sainikhil849/momo-esp32c3-desk-companion/4_Pictures/46_expressions.png

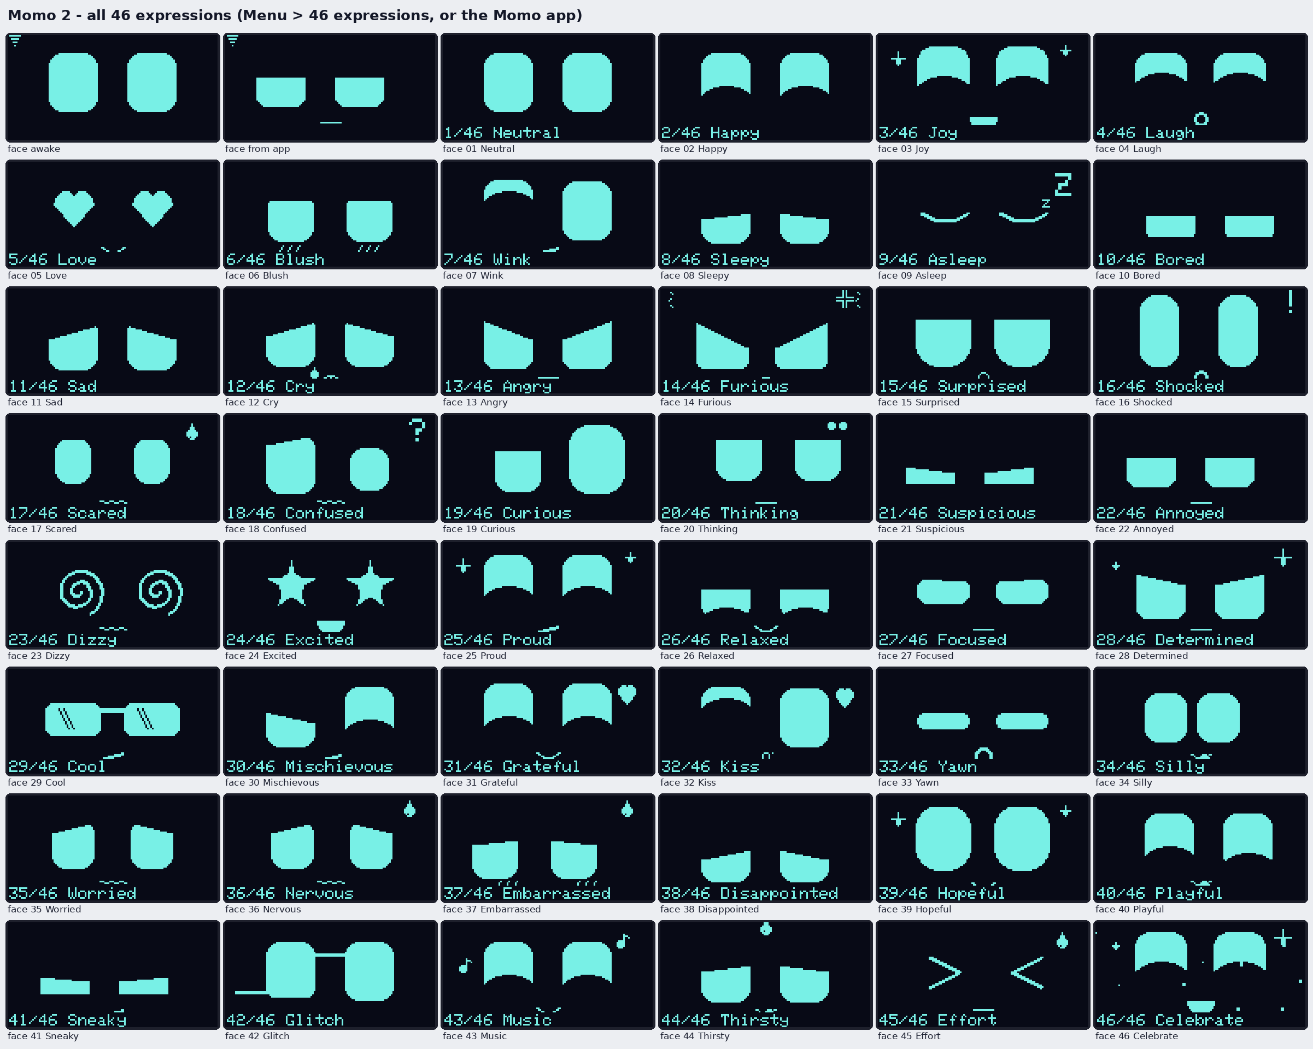
4_Pictures/46_expressions.png
