sainikhil849/momo-esp32c3-desk-companion/4_Pictures/app_01_pair.png

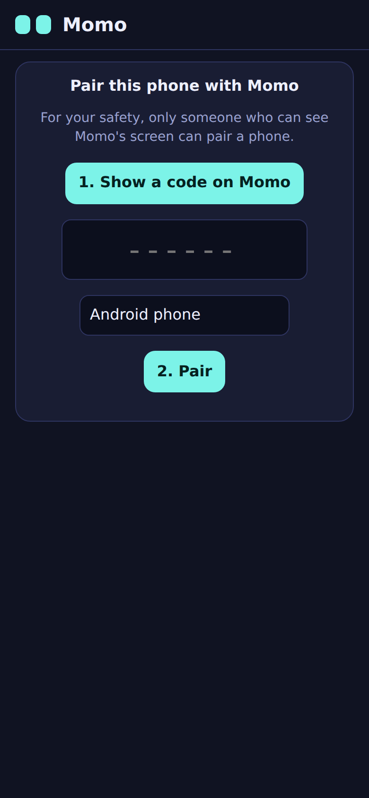
4_Pictures/app_01_pair.png
