sainikhil849/momo-esp32c3-desk-companion/4_Pictures/app_06_more.png

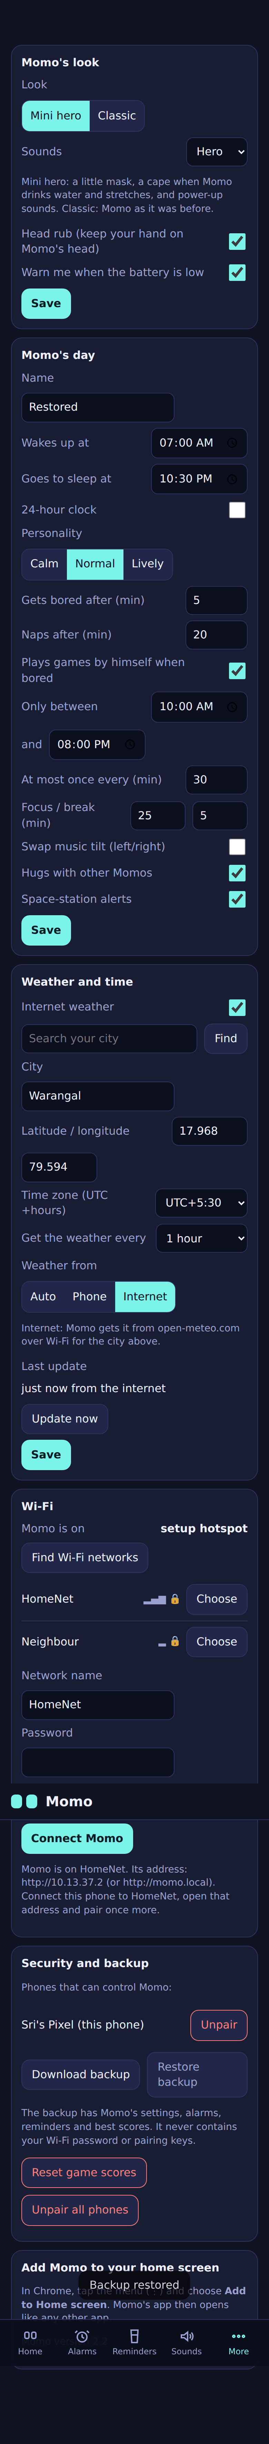
4_Pictures/app_06_more.png
