sainikhil849/momo-esp32c3-desk-companion/4_Pictures/enclosures_three.png

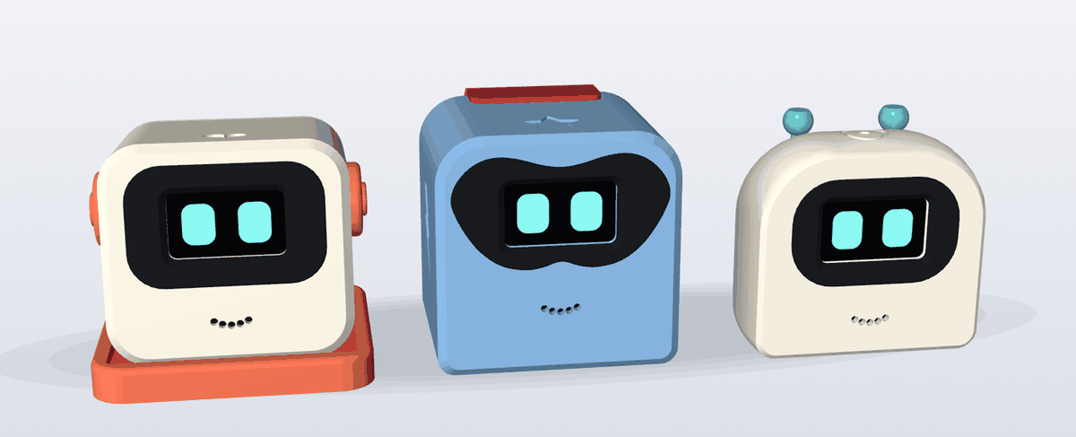
4_Pictures/enclosures_three.png
