sainikhil849/momo-esp32c3-desk-companion/4_Pictures/my_reminders.png

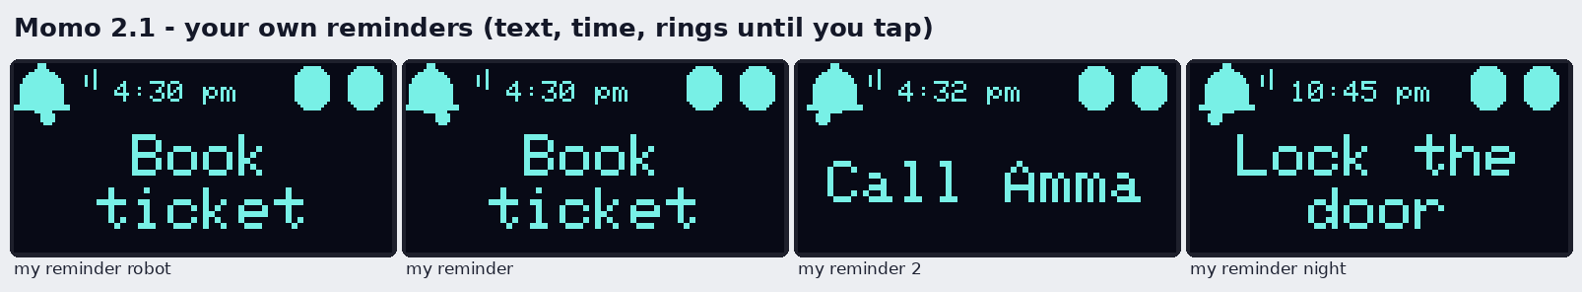
4_Pictures/my_reminders.png
