sainikhil849/momo-esp32c3-desk-companion/4_Pictures/new_games.png

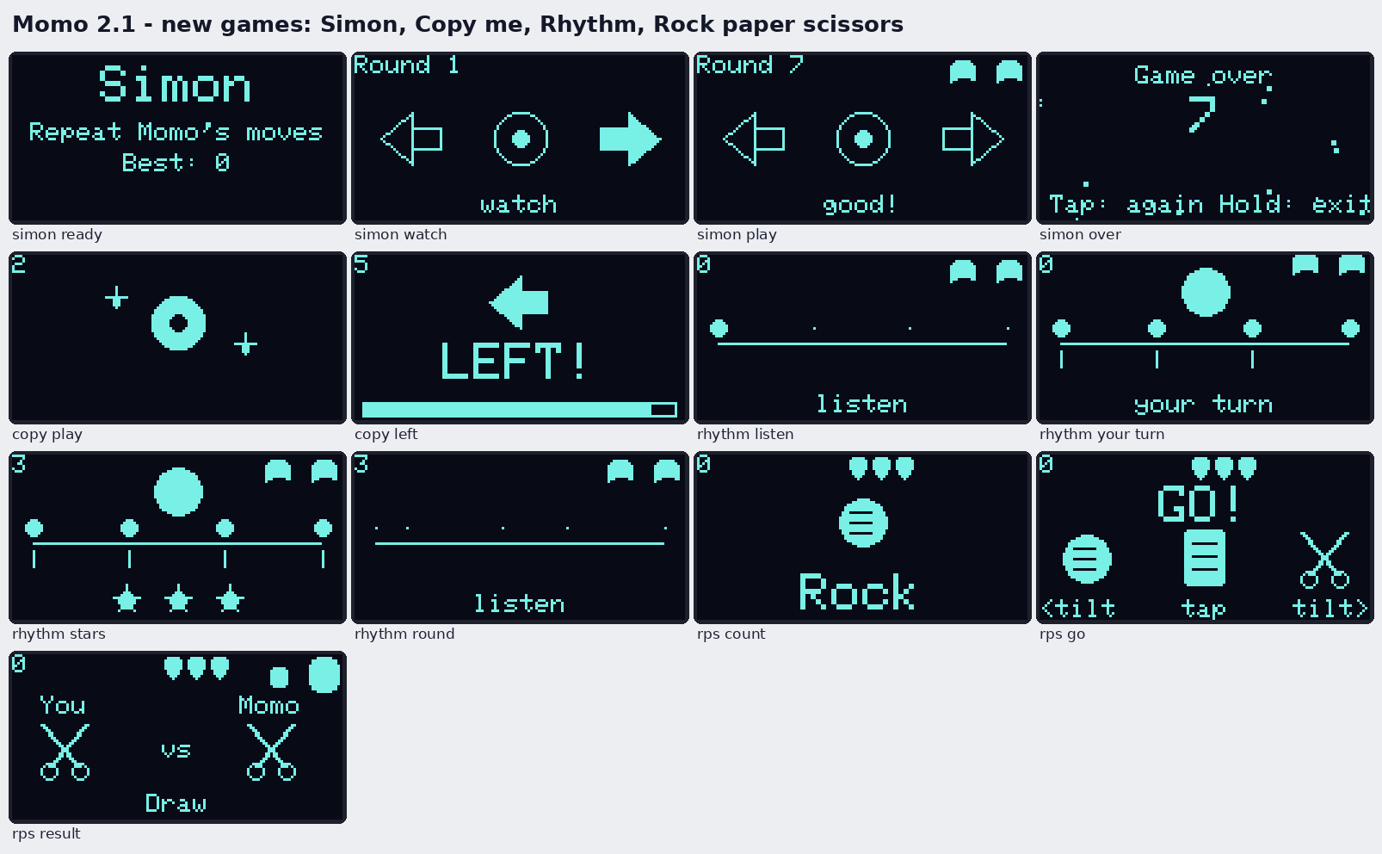
4_Pictures/new_games.png
