sainikhil849/momo-esp32c3-desk-companion/4_Pictures/screens_robot_phone.png

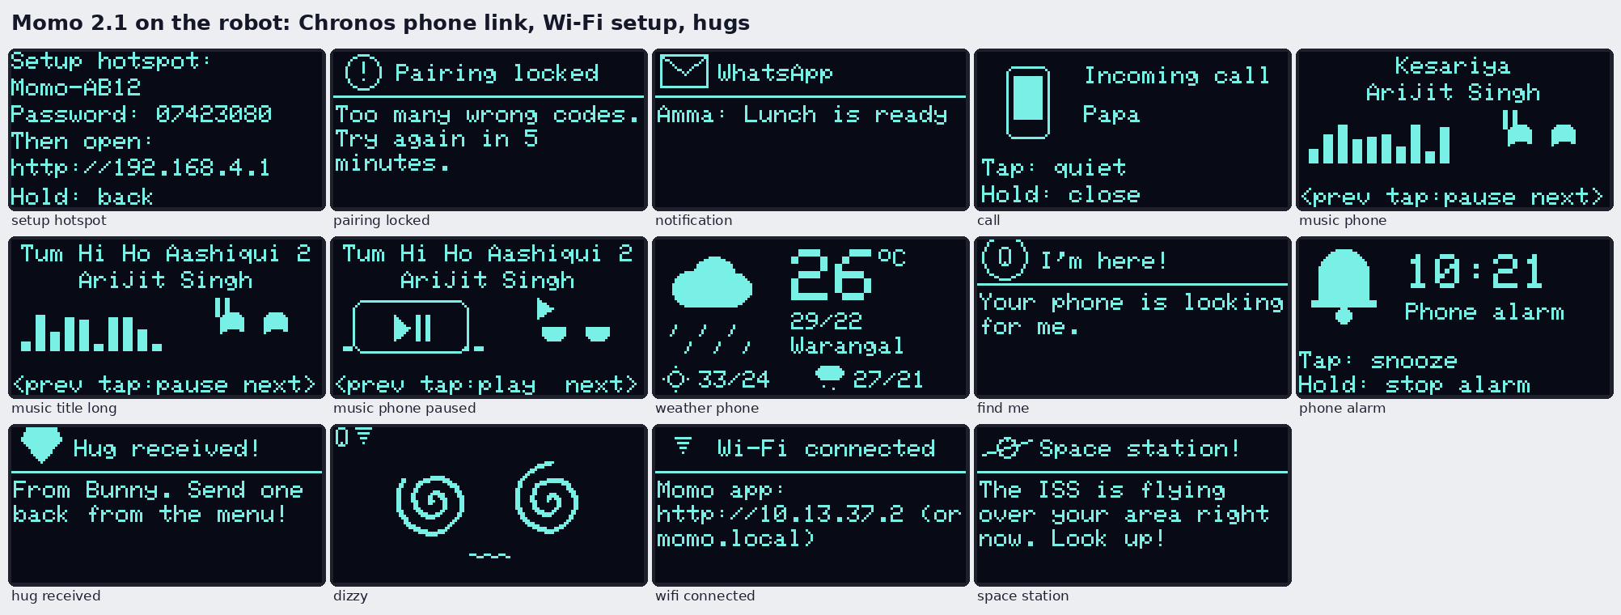
4_Pictures/screens_robot_phone.png
