sainikhil849/momo-esp32c3-desk-companion/4_Pictures/screens_simulator.png

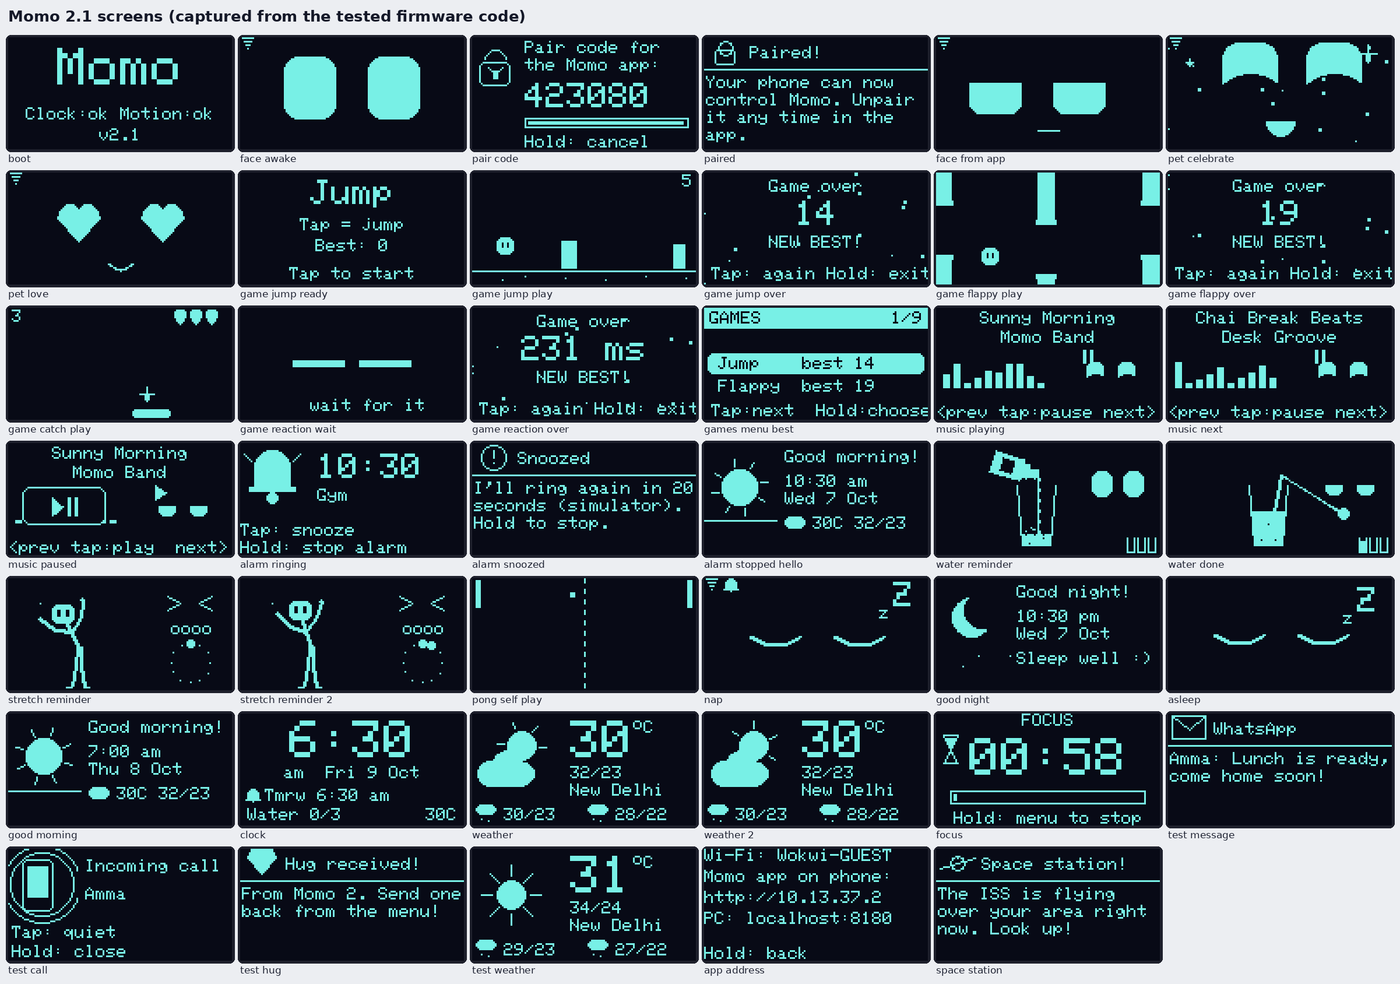
4_Pictures/screens_simulator.png
