sainikhil849/momo-esp32c3-desk-companion/4_Pictures/water_and_stretch_animations.png

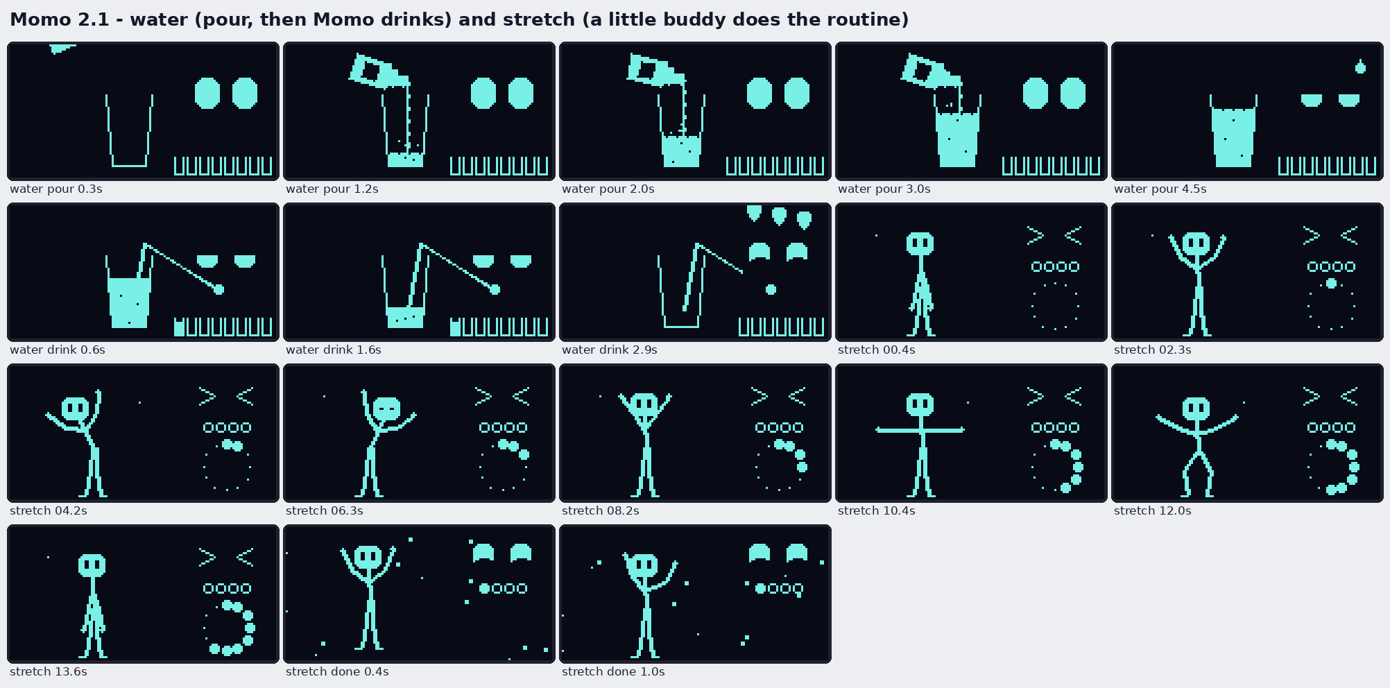
4_Pictures/water_and_stretch_animations.png
