sainikhil849/momo-esp32c3-desk-companion/5_Enclosures/pictures/A_cube_top.png

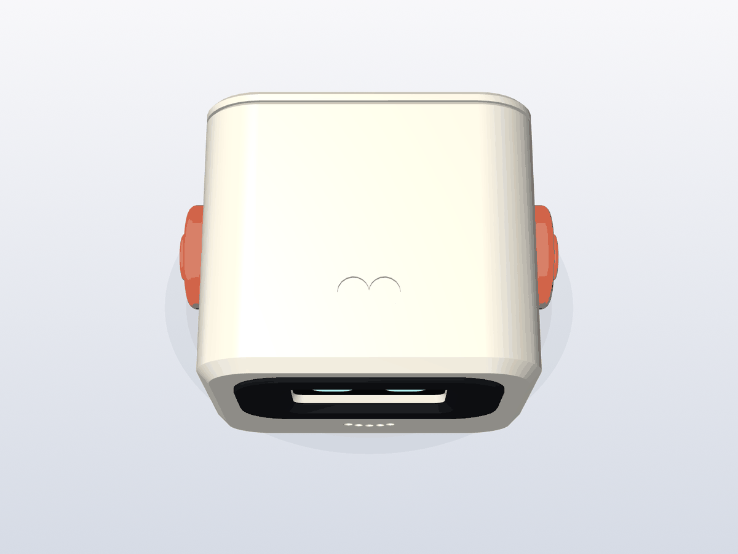
5_Enclosures/pictures/A_cube_top.png
