sainikhil849/momo-esp32c3-desk-companion/5_Enclosures/A_Momo_Cube/A_Cube_plate2_coral.3mf

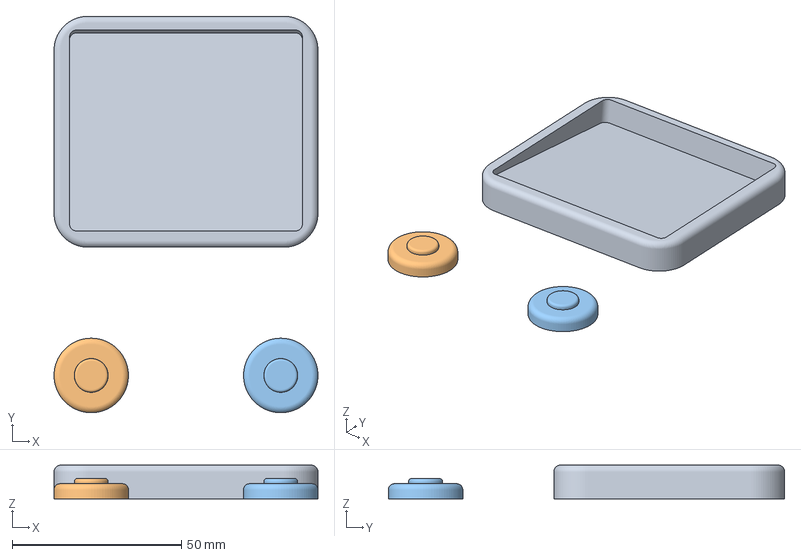
[picture p56: CAD file, 2026-10-12]
5_Enclosures/A_Momo_Cube/A_Cube_plate2_coral.3mf
78.0 x 117.1 x 10.0 mm
A_cube_dock_1
A_cube_ear_2
A_cube_ear_3
