sainikhil849/momo-esp32c3-desk-companion/5_Enclosures/A_Momo_Cube/STEP/A_cube_ear.step

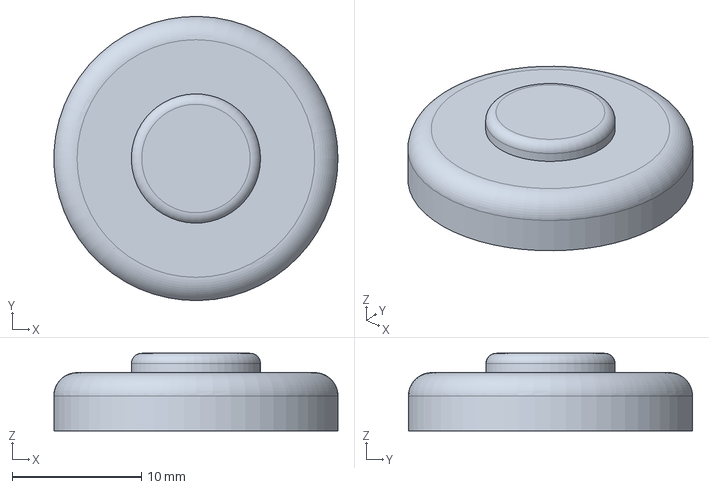
[picture p57: CAD file, 2026-10-12]
5_Enclosures/A_Momo_Cube/STEP/A_cube_ear.step
22.0 x 22.0 x 6.00 mm
