sainikhil849/momo-esp32c3-desk-companion/5_Enclosures/B_Momo_Pod/B_Pod_plate2_mint.3mf

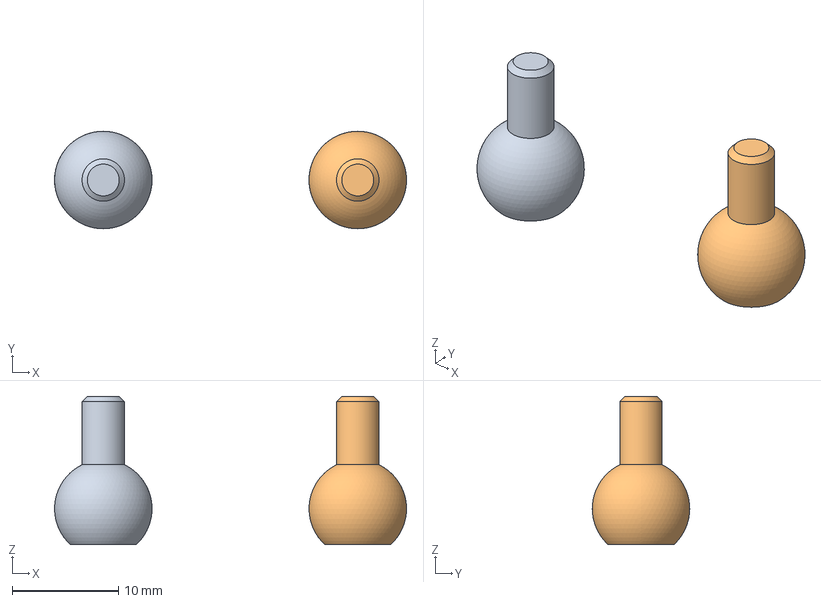
[picture p58: CAD file, 2026-10-12]
5_Enclosures/B_Momo_Pod/B_Pod_plate2_mint.3mf
33.2 x 9.20 x 14.0 mm
B_pod_antenna_1
B_pod_antenna_2
