sainikhil849/momo-esp32c3-desk-companion/5_Enclosures/B_Momo_Pod/STEP/B_pod_antenna.step

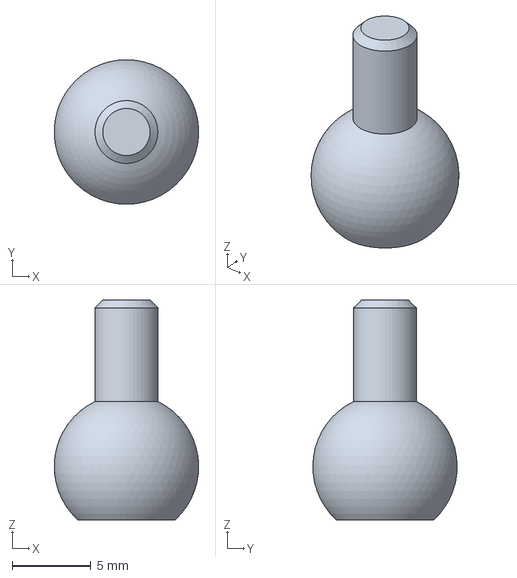
[picture p59: CAD file, 2026-10-12]
5_Enclosures/B_Momo_Pod/STEP/B_pod_antenna.step
9.19 x 9.20 x 14.0 mm
