sainikhil849/momo-esp32c3-desk-companion/5_Enclosures/C_Hero_Momo/C_Hero_plate2_red.3mf

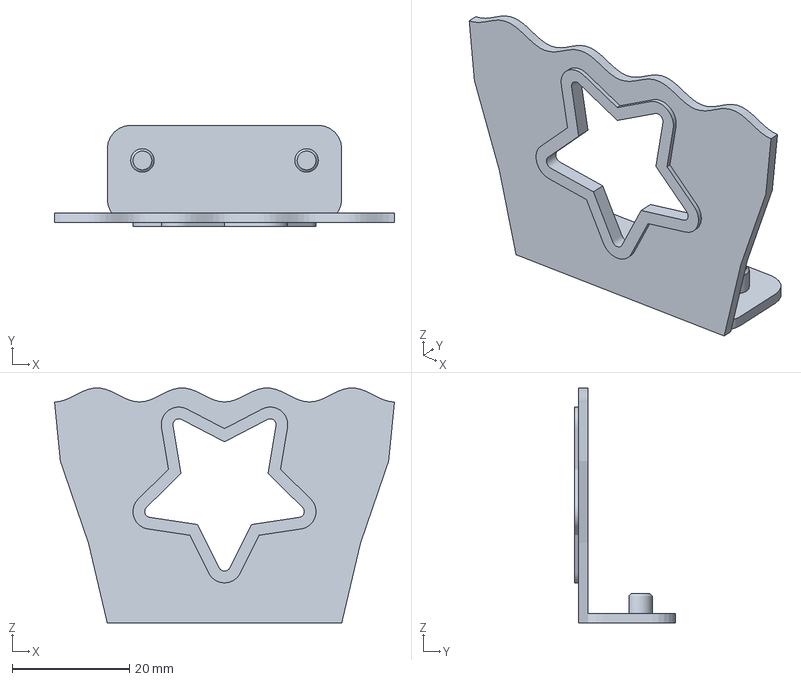
[picture p60: CAD file, 2026-10-12]
5_Enclosures/C_Hero_Momo/C_Hero_plate2_red.3mf
58.0 x 17.3 x 40.1 mm
