sainikhil849/momo-esp32c3-desk-companion/5_Enclosures/C_Hero_Momo/STEP/C_hero_mask.step

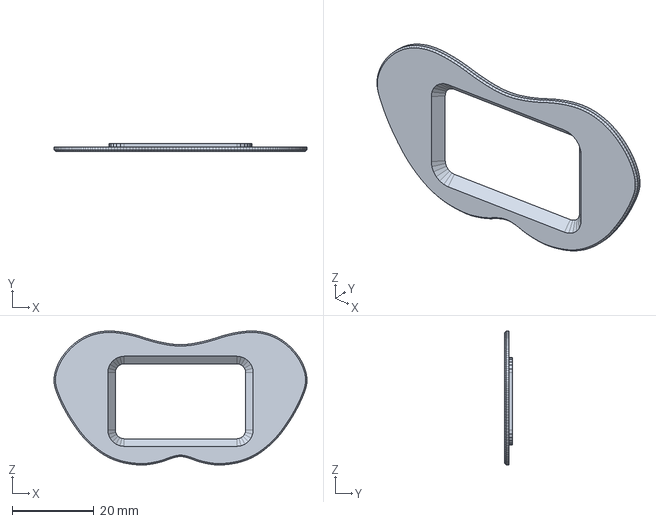
[picture p61: CAD file, 2026-10-12]
5_Enclosures/C_Hero_Momo/STEP/C_hero_mask.step
61.8 x 1.85 x 32.7 mm
