sainikhil849/momo-esp32c3-desk-companion/5_Enclosures/A_Momo_Cube/A_Cube_plate3_black.3mf

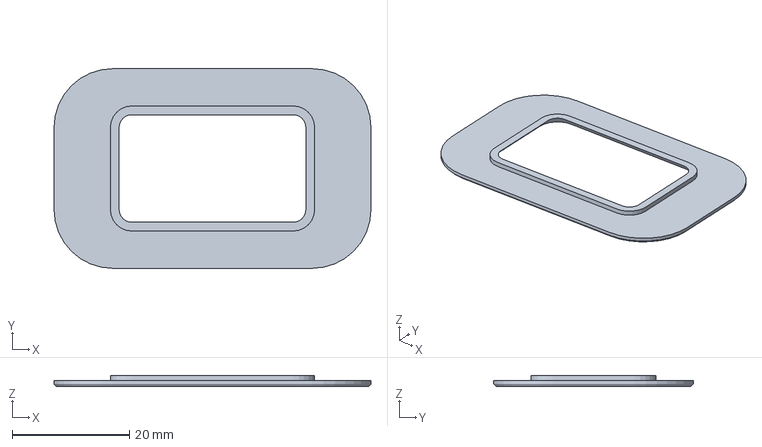
[picture p62: CAD file, 2026-10-12]
5_Enclosures/A_Momo_Cube/A_Cube_plate3_black.3mf
54.0 x 34.0 x 1.85 mm
