sainikhil849/momo-esp32c3-desk-companion/5_Enclosures/B_Momo_Pod/B_Pod_plate3_black.3mf

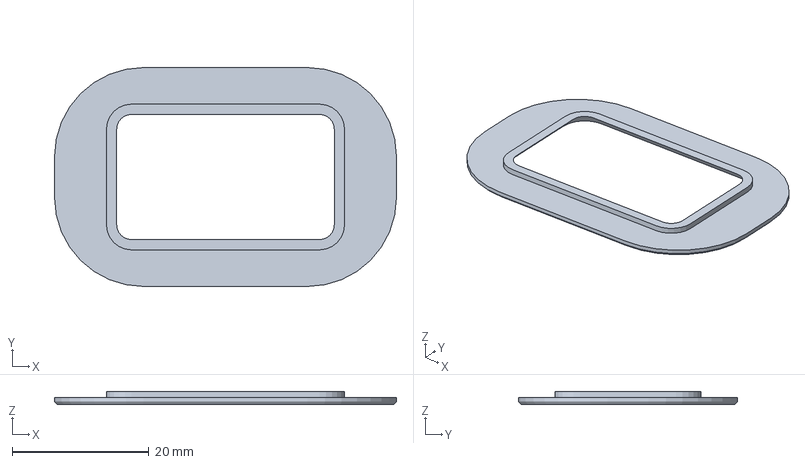
[picture p63: CAD file, 2026-10-12]
5_Enclosures/B_Momo_Pod/B_Pod_plate3_black.3mf
50.0 x 32.0 x 1.85 mm
