sainikhil849/momo-esp32c3-desk-companion/5_Enclosures/B_Momo_Pod/STEP/B_pod_back.step

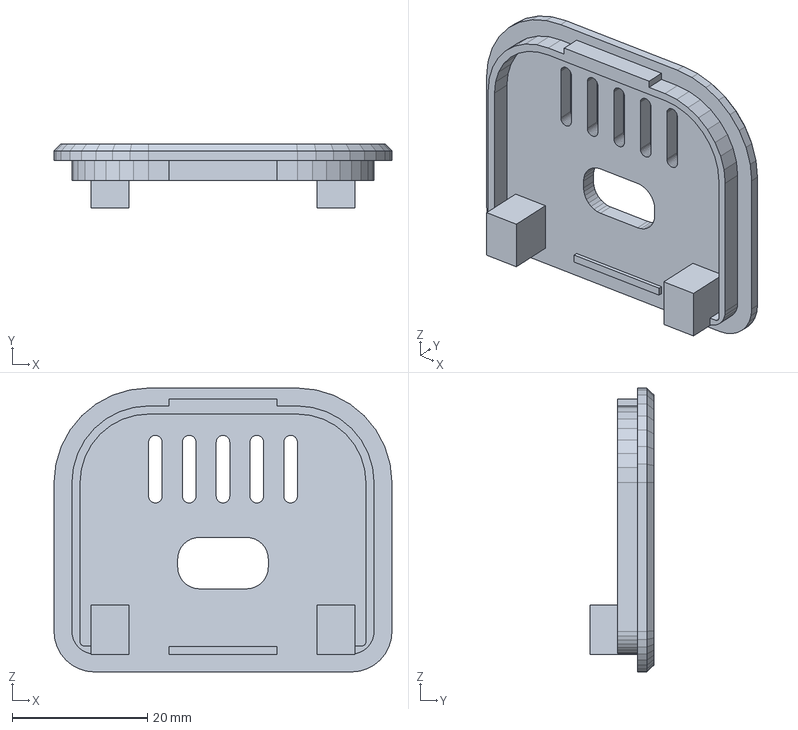
[picture p64: CAD file, 2026-10-12]
5_Enclosures/B_Momo_Pod/STEP/B_pod_back.step
50.0 x 9.40 x 42.0 mm
