sainikhil849/momo-esp32c3-desk-companion/5_Enclosures/C_Hero_Momo/STEP/oled_retainer.step

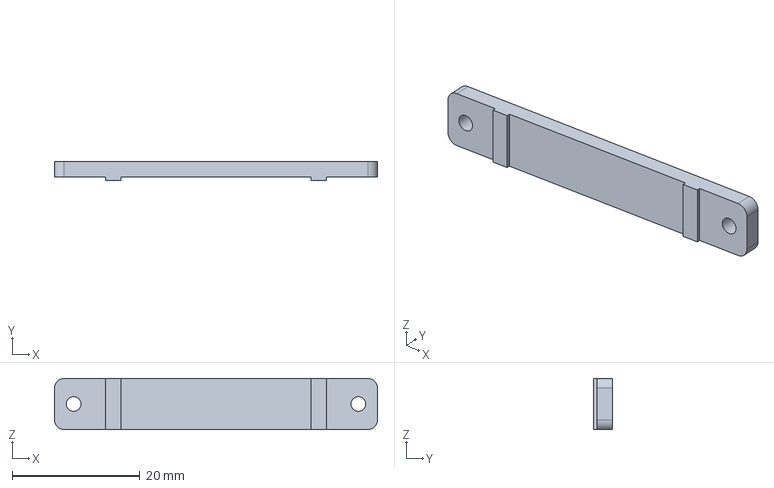
[picture p65: CAD file, 2026-10-12]
5_Enclosures/C_Hero_Momo/STEP/oled_retainer.step
50.6 x 2.90 x 8.00 mm
