sainikhil849/momo-esp32c3-desk-companion/5_Enclosures/A_Momo_Cube/A_Cube_plate1_white.3mf

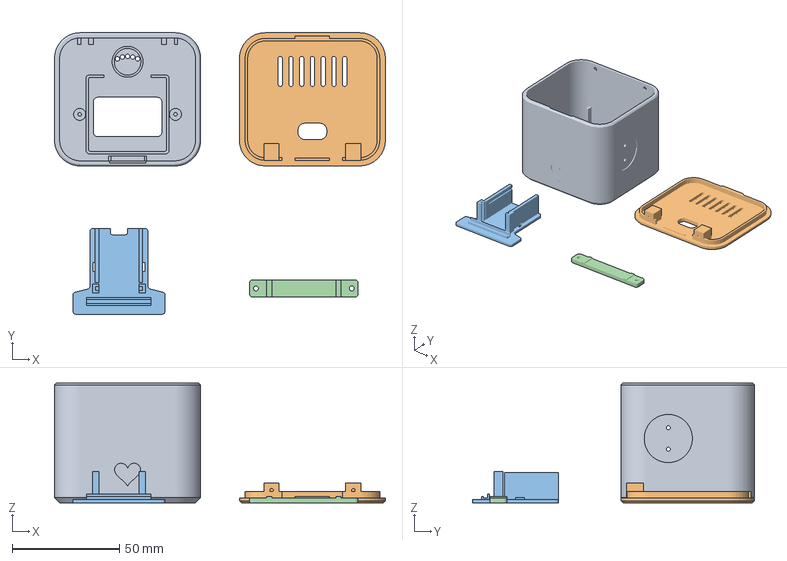
[picture p66: CAD file, 2026-10-12]
5_Enclosures/A_Momo_Cube/A_Cube_plate1_white.3mf
154.0 x 131.0 x 55.8 mm
A_cube_shell_1
A_cube_back_2
tray_3
oled_retainer_4
