sainikhil849/momo-esp32c3-desk-companion/5_Enclosures/B_Momo_Pod/B_Pod_plate1_white.3mf

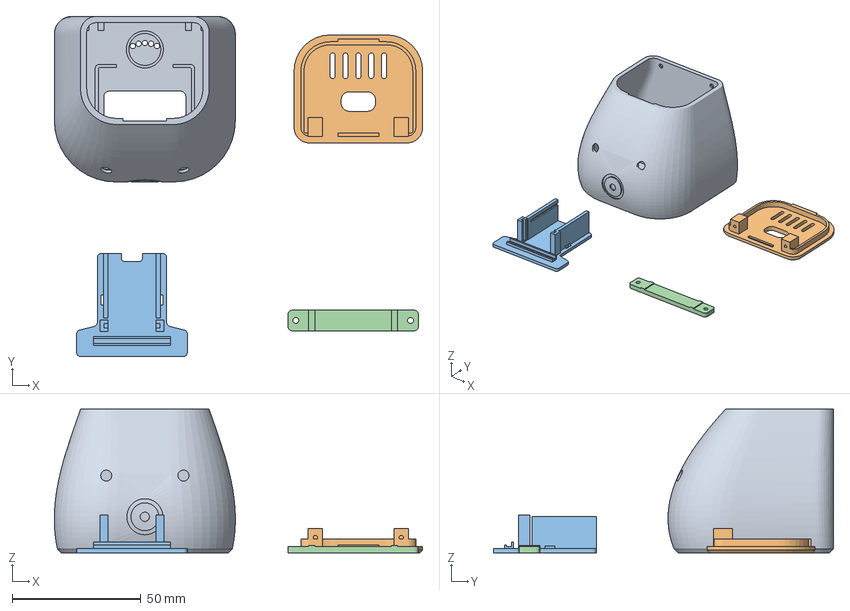
[picture p67: CAD file, 2026-10-12]
5_Enclosures/B_Momo_Pod/B_Pod_plate1_white.3mf
143.2 x 132.2 x 55.8 mm
B_pod_shell_1
B_pod_back_2
tray_3
oled_retainer_4
