sainikhil849/momo-esp32c3-desk-companion/5_Enclosures/B_Momo_Pod/STEP/tray.step

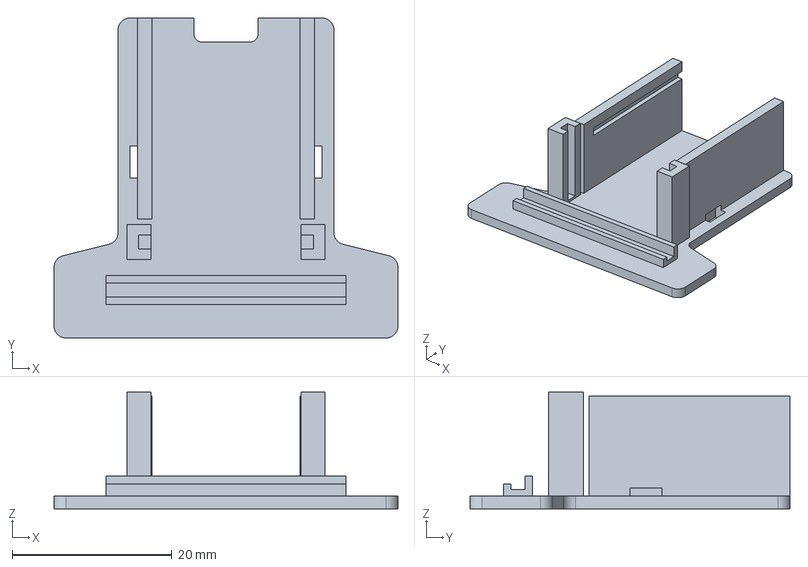
[picture p68: CAD file, 2026-10-12]
5_Enclosures/B_Momo_Pod/STEP/tray.step
43.0 x 40.0 x 14.6 mm
