sainikhil849/momo-esp32c3-desk-companion/5_Enclosures/C_Hero_Momo/C_Hero_plate1_blue.3mf

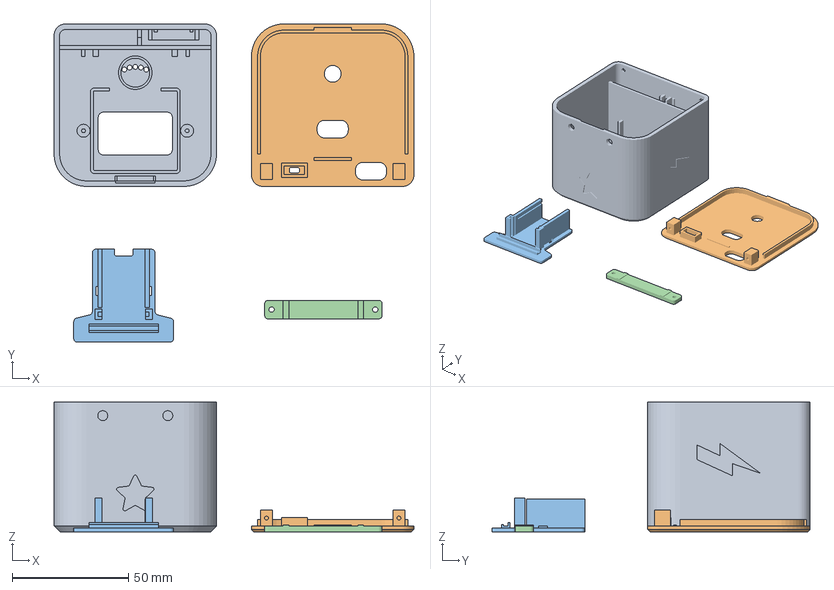
[picture p69: CAD file, 2026-10-12]
5_Enclosures/C_Hero_Momo/C_Hero_plate1_blue.3mf
155.0 x 137.0 x 55.8 mm
C_hero_shell_1
C_hero_back_2
tray_3
oled_retainer_4
