sainikhil849/momo-esp32c3-desk-companion/5_Enclosures/A_Momo_Cube/STEP/A_cube_back.step

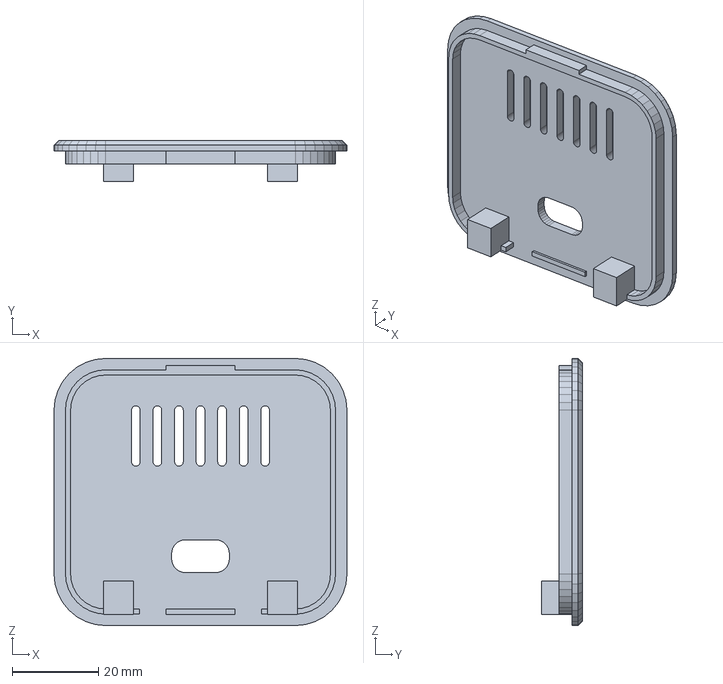
[picture p70: CAD file, 2026-10-12]
5_Enclosures/A_Momo_Cube/STEP/A_cube_back.step
68.0 x 9.40 x 62.0 mm
