sainikhil849/momo-esp32c3-desk-companion/5_Enclosures/C_Hero_Momo/STEP/C_hero_back.step

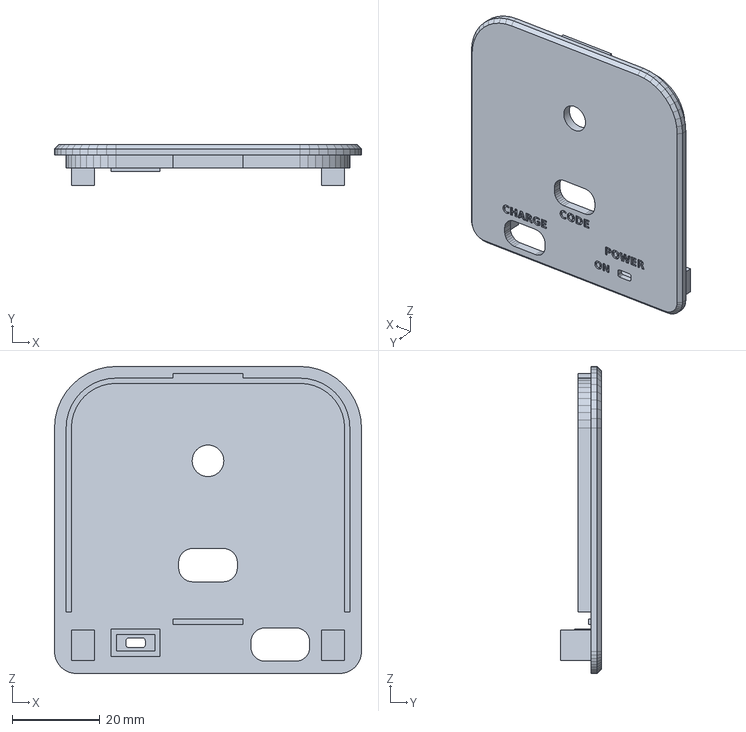
[picture p71: CAD file, 2026-10-12]
5_Enclosures/C_Hero_Momo/STEP/C_hero_back.step
70.0 x 9.40 x 70.0 mm
