sainikhil849/momo-esp32c3-desk-companion/5_Enclosures/A_Momo_Cube/STEP/A_cube_dock.step

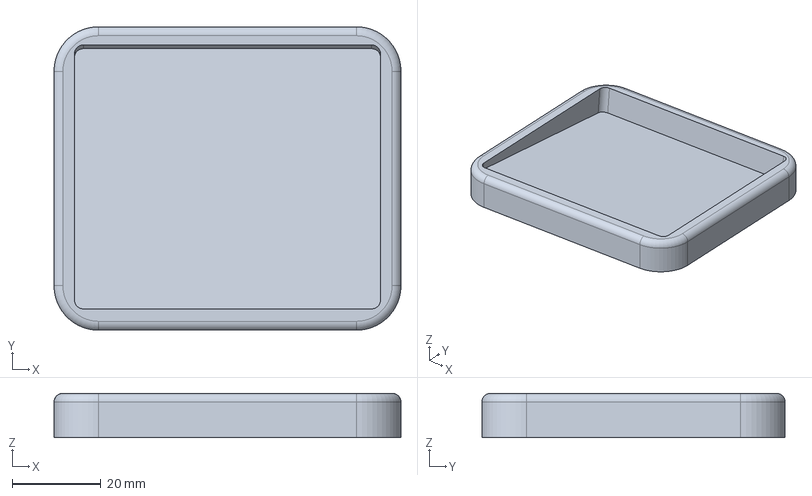
[picture p72: CAD file, 2026-10-12]
5_Enclosures/A_Momo_Cube/STEP/A_cube_dock.step
78.0 x 68.2 x 10.0 mm
