sainikhil849/momo-esp32c3-desk-companion/5_Enclosures/A_Momo_Cube/STEP/A_cube_shell.step

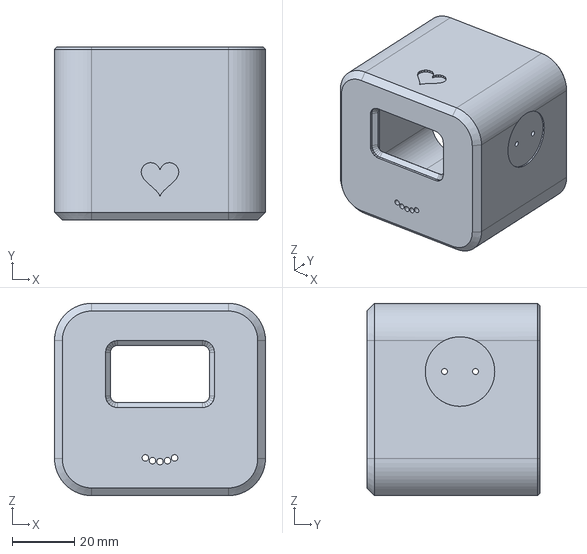
[picture p73: CAD file, 2026-10-12]
5_Enclosures/A_Momo_Cube/STEP/A_cube_shell.step
68.0 x 55.8 x 62.0 mm
