sainikhil849/momo-esp32c3-desk-companion/5_Enclosures/B_Momo_Pod/STEP/B_pod_shell.step

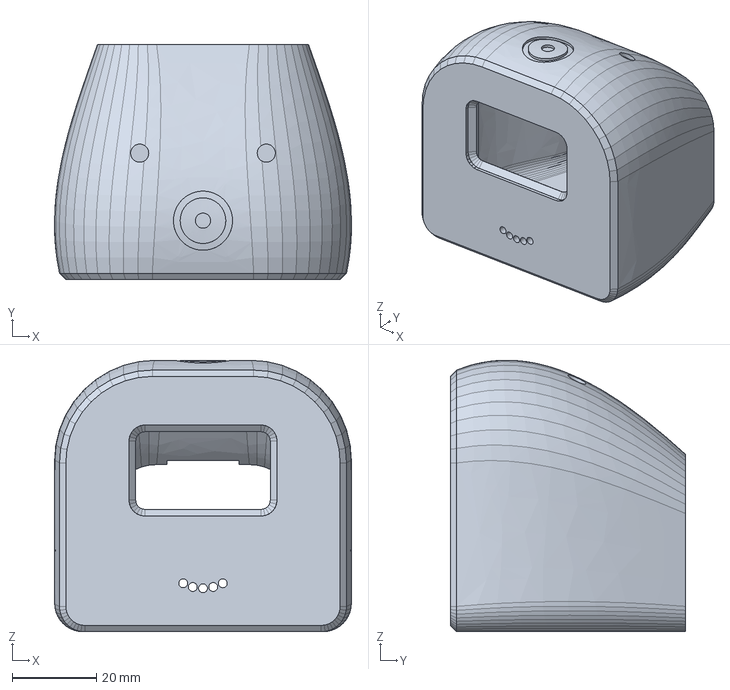
[picture p74: CAD file, 2026-10-12]
5_Enclosures/B_Momo_Pod/STEP/B_pod_shell.step
70.4 x 55.8 x 64.3 mm
