sainikhil849/momo-esp32c3-desk-companion/5_Enclosures/C_Hero_Momo/STEP/C_hero_shell.step

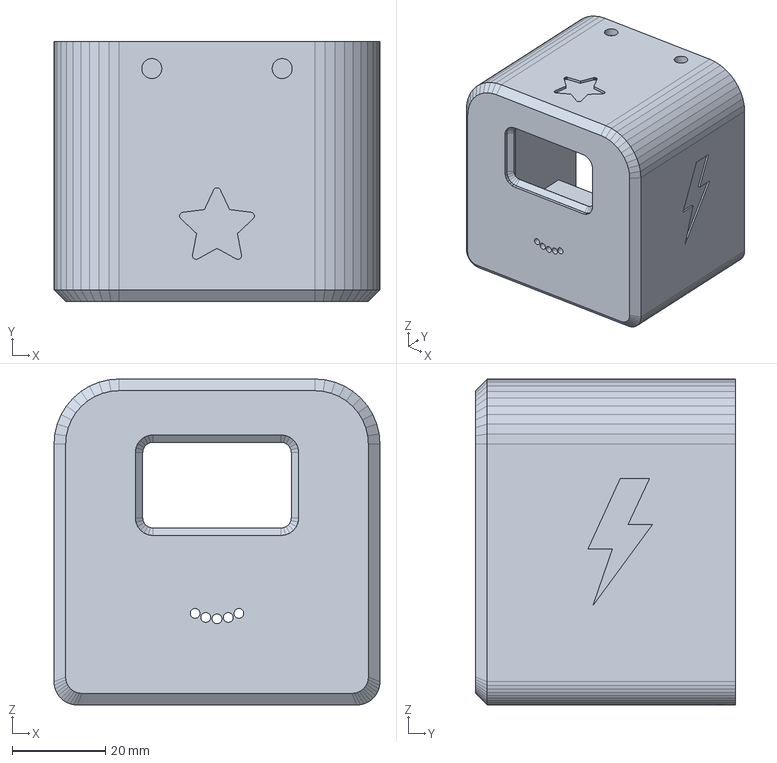
[picture p75: CAD file, 2026-10-12]
5_Enclosures/C_Hero_Momo/STEP/C_hero_shell.step
70.0 x 55.8 x 70.0 mm
