sainikhil849/momo-esp32c3-desk-companion/(list of files, cad)

Other CAD files:
5_Enclosures/A_Momo_Cube/STEP/A_cube_visor.step
5_Enclosures/C_Hero_Momo/C_Hero_plate3_black.3mf
5_Enclosures/A_Momo_Cube/STEP/oled_retainer.step
5_Enclosures/C_Hero_Momo/STEP/C_hero_cape.step
5_Enclosures/B_Momo_Pod/STEP/B_pod_visor.step
5_Enclosures/B_Momo_Pod/STEP/oled_retainer.step
5_Enclosures/C_Hero_Momo/STEP/tray.step
5_Enclosures/A_Momo_Cube/STL/A_cube_back.stl
5_Enclosures/A_Momo_Cube/STL/A_cube_dock.stl
5_Enclosures/A_Momo_Cube/STL/A_cube_ear.stl
5_Enclosures/A_Momo_Cube/STL/A_cube_shell.stl
5_Enclosures/A_Momo_Cube/STL/A_cube_visor.stl
5_Enclosures/A_Momo_Cube/STL/oled_retainer.stl
5_Enclosures/A_Momo_Cube/STL/tray.stl
5_Enclosures/B_Momo_Pod/STL/B_pod_antenna.stl
5_Enclosures/B_Momo_Pod/STL/B_pod_back.stl
5_Enclosures/B_Momo_Pod/STL/B_pod_shell.stl
5_Enclosures/B_Momo_Pod/STL/B_pod_visor.stl
5_Enclosures/B_Momo_Pod/STL/oled_retainer.stl
5_Enclosures/B_Momo_Pod/STL/tray.stl
5_Enclosures/C_Hero_Momo/STL/C_hero_back.stl
5_Enclosures/C_Hero_Momo/STL/C_hero_cape.stl
5_Enclosures/C_Hero_Momo/STL/C_hero_mask.stl
5_Enclosures/C_Hero_Momo/STL/C_hero_shell.stl
5_Enclosures/C_Hero_Momo/STL/oled_retainer.stl
5_Enclosures/C_Hero_Momo/STL/tray.stl
